parkerswanson/rocket-kinematics/PCBSp2018.JPG

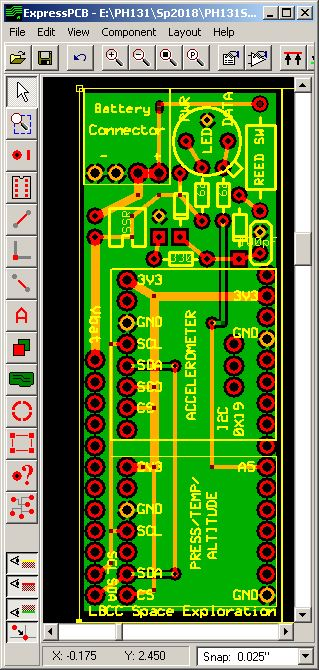
PCBSp2018.JPG
