parkerswanson/rocket-kinematics/README.md

# RocketKinematics

30 Dec 2019:

This README.md file has been superseded by file UpdatedREADME.docx in this repository. Thanks!
