parkerswanson/rocket-kinematics/Flight25Feb.png

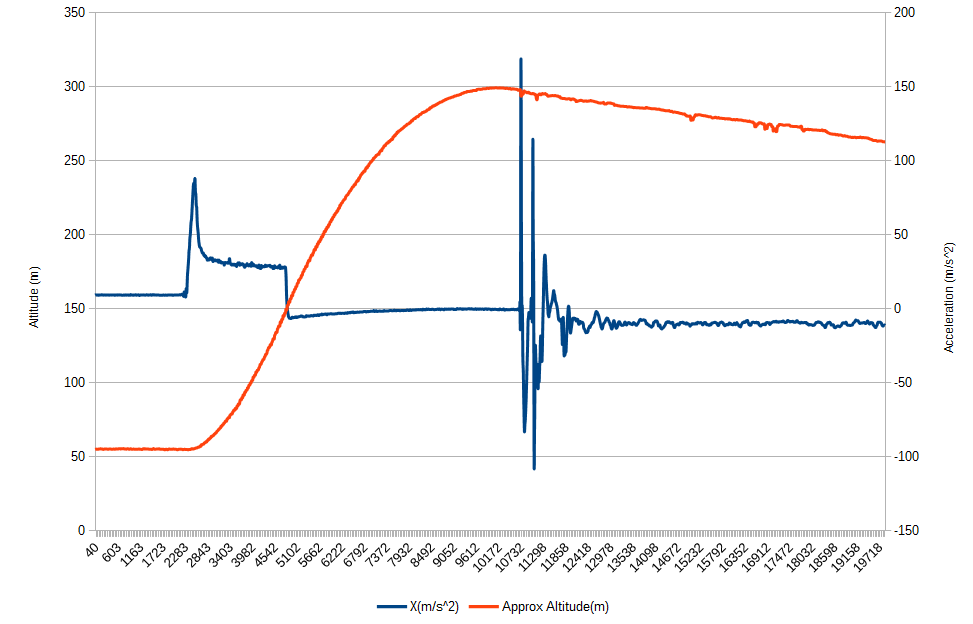
Flight25Feb.png
