parkerswanson/rocket-kinematics/PCBSp2018pads.bmp

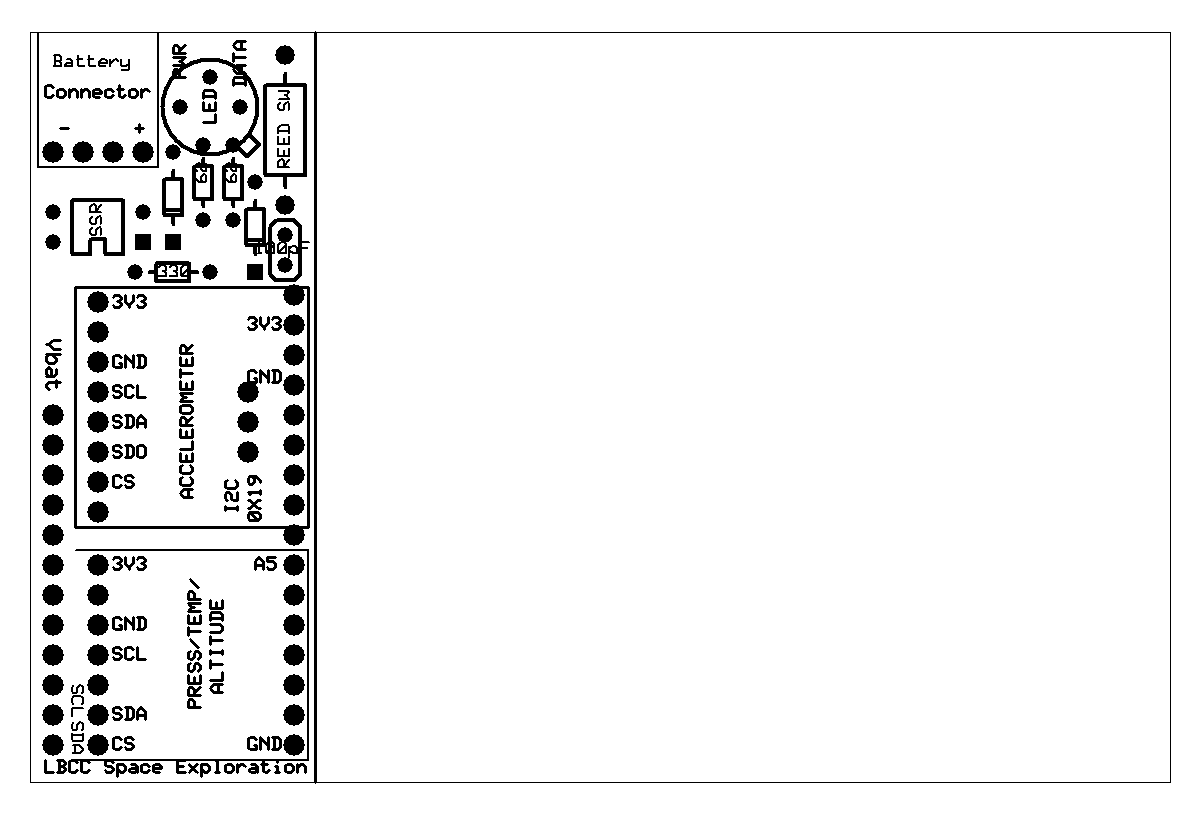
PCBSp2018pads.bmp
