parkerswanson/rocket-kinematics/PH131SchDec2019.bmp

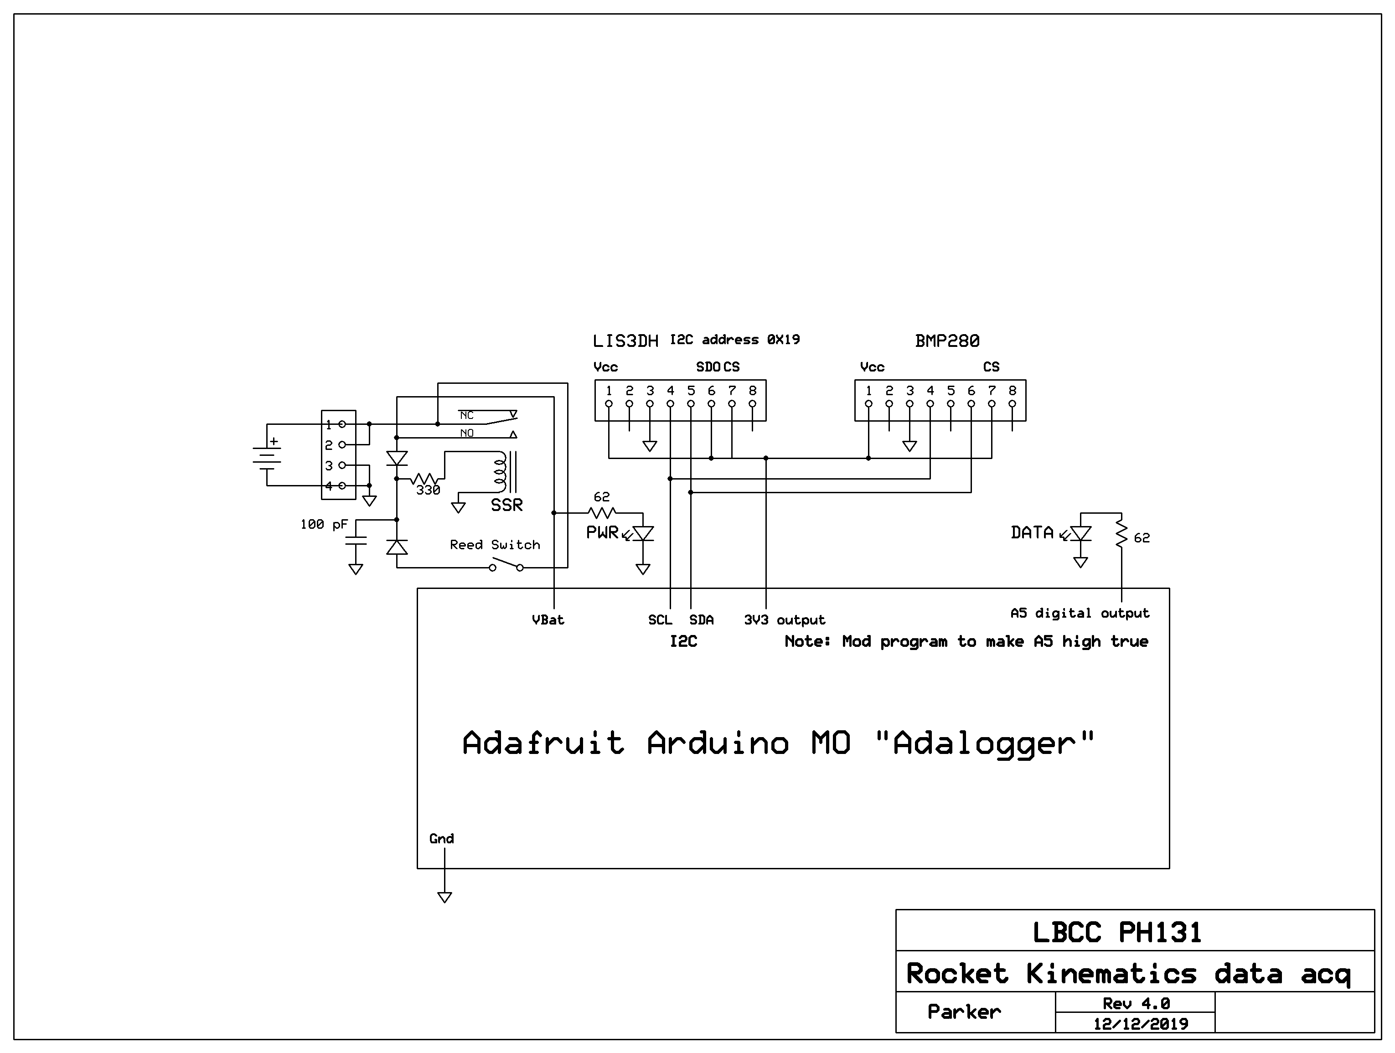
PH131SchDec2019.bmp
