parkerswanson/rocket-kinematics/(list of files, drawings)

Other design files:
PH131Dec2019.pcb
PH131Jan2022NewBoards.pcb
