parkerswanson/rocket-kinematics/(commit log)

2022-01-25 Add files via upload
    ExpressPCB .pcb file updated for new Adafruit sensors layout
    [PH131Jan2022x3.pcb]
2022-01-26 Add files via upload
    ExpressPCB .pcb file updated to use new larger Adafruit sensor boards, now 3.1" x 0.95". 2 boards can be sawn from ExpressPCB mini board.
    [PH131Jan2022NewBoards.pcb]
